FigJam23/HRV-TouchLCD-CristalAir-Invision-Serial-to-HA/HRV BUS Comms Interface/Readme.md

# Bus Comms 

<p align="center">
  <br>
  <em>This is what’s required to communicate with the HRV half-duplex TTL bus use 4k7 resistos</em>
</p>
# Comming Soon 

Instructions To build the Needed half Duplex Comms Device (Required for full Control of Fans ETC)
