FigJam23/HRV-TouchLCD-CristalAir-Invision-Serial-to-HA/ESP32/readme.md

Same As Touch Screen Binary Only change rx tx on pins 16 17 (Works with or with out a touch screen conected)




UI Screens
