FigJam23/HRV-TouchLCD-CristalAir-Invision-Serial-to-HA/Arduino Keypad Clone ESP32/Readme.md

https://youtube.com/shorts/8ISQGKKpurk?si=fGekwMP1LDX2R__V

```
static const char* AP_SSID       = "HRV-Keypad";
static const char* AP_PASS       = "12345678";  // 8+ chars required by ESP

// MQTT topics
static const char* T_FILTER_DAYS     = "hassio/hrv/filter_days_remaining/state";
static const char* T_FILTER_LIFE     = "hassio/hrv/filter_life/state";
static const char* T_FAN_PERCENT     = "hassio/hrv/fan_percent/state";
static const char* T_BOOST_ACTIVE    = "hassio/hrv/boost_active/state";
static const char* T_FILTER_NEEDED   = "hassio/hrv/filter_replacement_needed";
static const char* T_HOUSE_TEMP      = "hassio/hrv/house_temp/state";
static const char* T_HOUSE_HUM       = "hassio/hrv/house_humidity/state";
static const char* T_SETPOINT_STATE  = "hassio/hrv/setpoint/state"; // retained
static const char* T_SETPOINT_CMD    = "hassio/hrv/setpoint/set";   // retained command (optional from HA)
// Burnt Toast countdown
static const char* T_BOOST_REMAIN_S  = "hassio/hrv/boost_remaining_s/state";
static const char* T_BOOST_TOTAL_S   = "hassio/hrv/boost_total_s/state";
```
<table>
  <tr>
    <td></td>
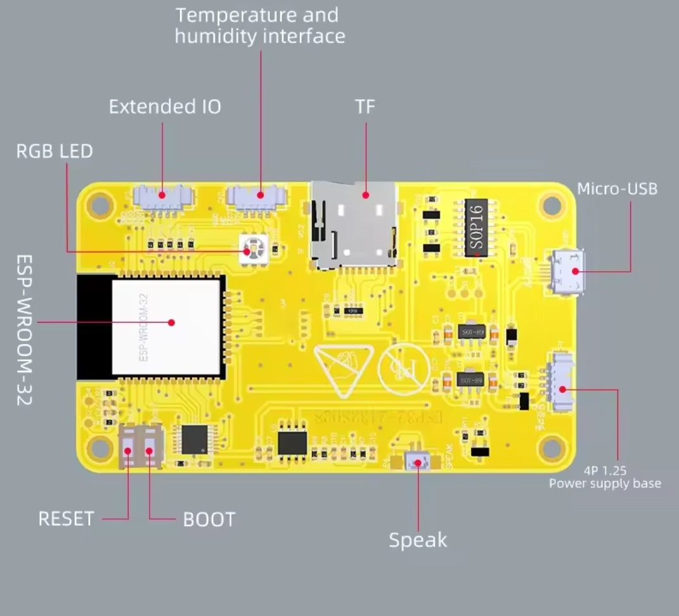
[picture p2: Arduino Keypad Clone ESP32/Screenshot_20250811_145851_AliExpress.jpg]
    <td></td>
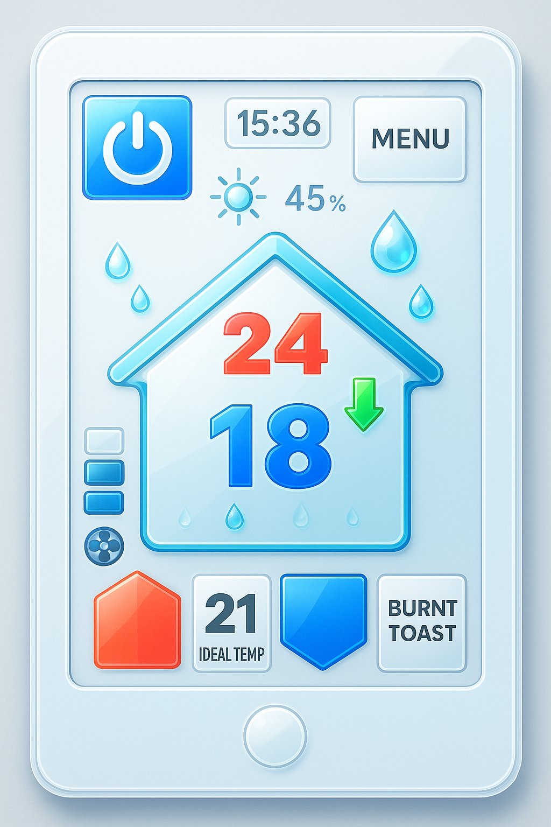
[picture p3: Arduino Keypad Clone ESP32/Keypad Home Screens/f7614291-c459-4cea-b07e-f4bfe5d946c0(4).png]
    <td></td>
  </tr>
  <tr>
    <td></td>
    <td></td>
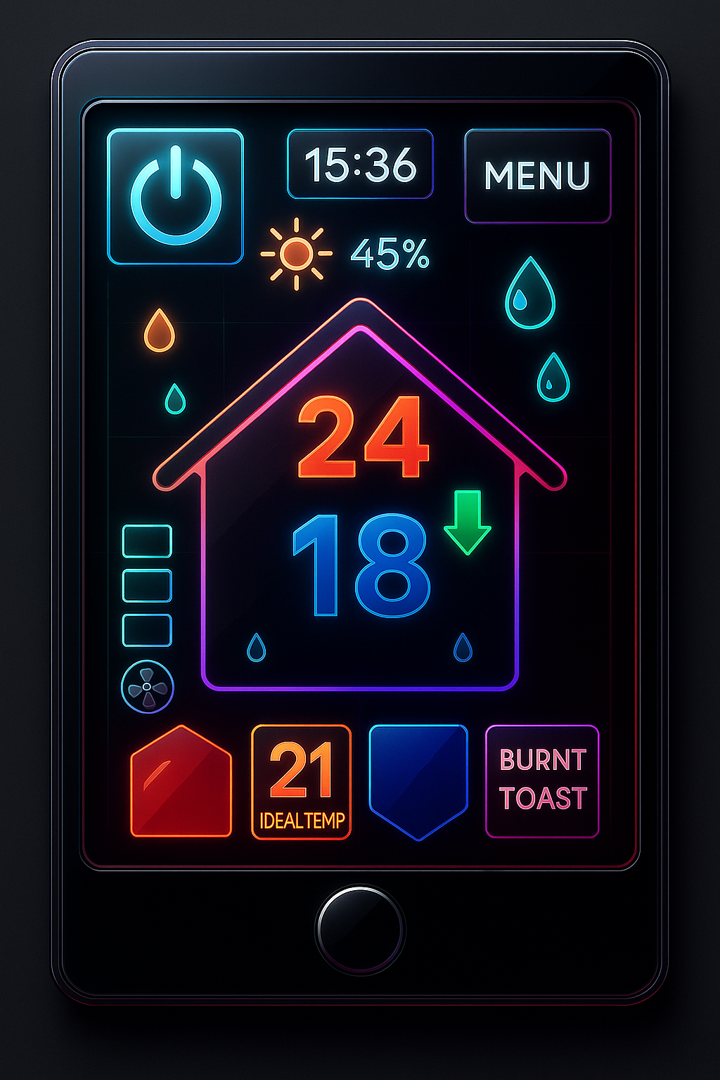
[picture p4: Arduino Keypad Clone ESP32/Keypad Home Screens/file_00000000ba5061f8b88bcc3f6a8952d6.png]
    <td></td>
  </tr>
  <tr>
    <td></td>
  </tr>
    <tr>
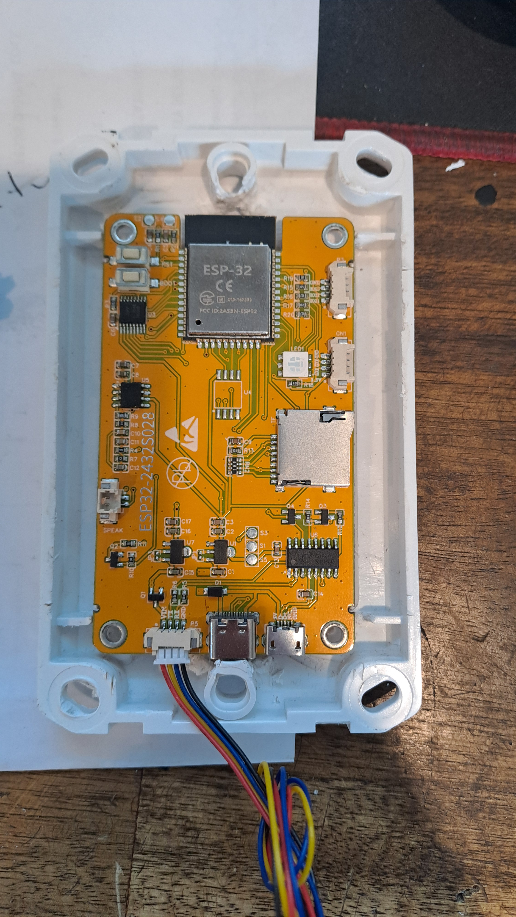
[picture p5: Arduino Keypad Clone ESP32/images/20250817_124352.jpg]
    <td></td>
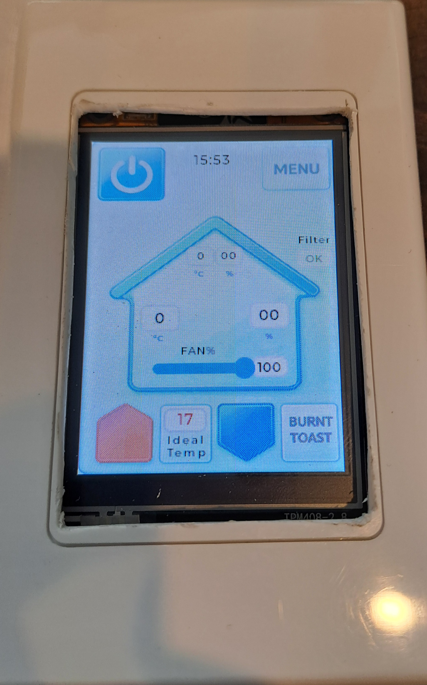
[picture p6: Arduino Keypad Clone ESP32/images/20250817_155330.jpg]
    <td></td>
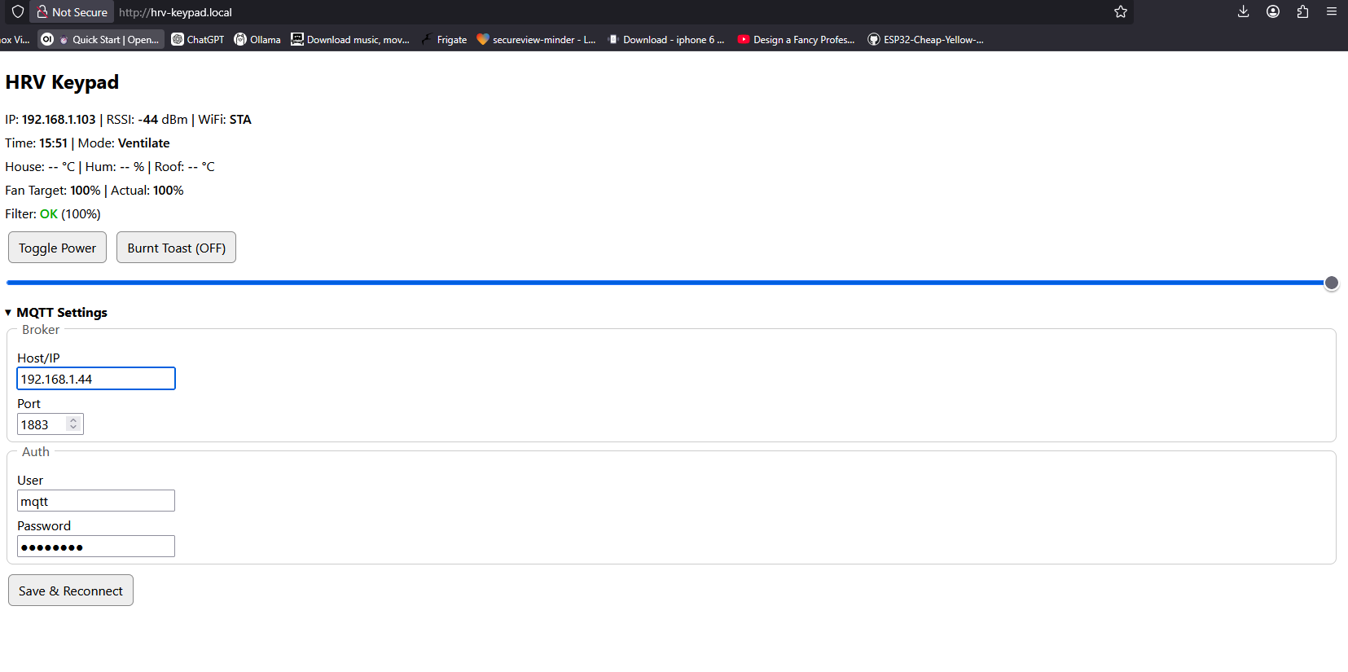
[picture p7: Arduino Keypad Clone ESP32/images/Screenshot 2025-08-17 155137.png]
    <td></td>
  </tr>
  <tr>
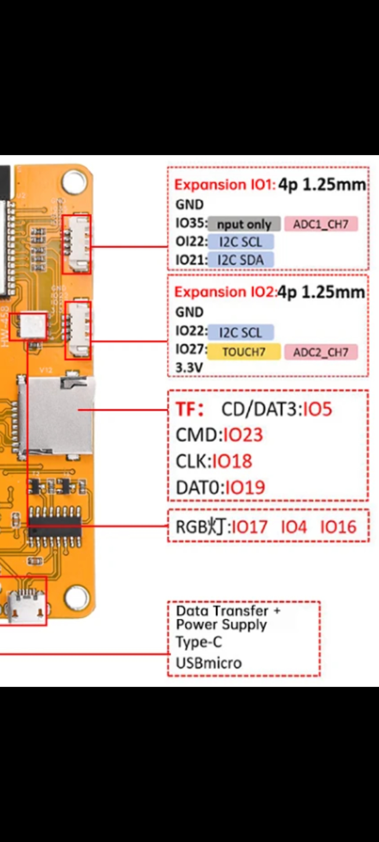
[picture p8: Arduino Keypad Clone ESP32/images/Screenshot_20250816_200522_Photos.jpg]
    <td></td>
    
    <td></td>
  </tr>

</table>
