FigJam23/HRV-TouchLCD-CristalAir-Invision-Serial-to-HA/Full Control Keypad Clone Bins/HRV ESP32 V4 Beta/Readme.md

All My main builds are based of the 2013 RV1e keypad, Seems some veriations between models etc Currently testing build for the RV2a 2015 version but not confirmed.

RV1e 2013 Confirmed Working 100pc
