FigJam23/HRV-TouchLCD-CristalAir-Invision-Serial-to-HA/Full Control Keypad Clone Bins/HRV ESP32 V4 Beta/HRV Keypad RV2a 2015/Readme.md

RV2a 2015 In testing

RV2a 2015
