FigJam23/HRV-TouchLCD-CristalAir-Invision-Serial-to-HA/Full Control Keypad Clone Bins/HRV ESP32 V4 Beta/4.6/Readme.md

Fixed Wifi Drop Issue, Hot cold temp icons poll on of when heating cooloing
