FigJam23/HRV-TouchLCD-CristalAir-Invision-Serial-to-HA/Full Control Keypad Clone Bins/HRV ESP32 V4 Beta/V42/Readme.md

Fixed Touch sounds on board speaker now working... Beep Beep
