FigJam23/HRV-TouchLCD-CristalAir-Invision-Serial-to-HA/Full Control Keypad Clone Bins/HRV ESP32 V3/ESP32 Only No Touch/Readme.md

```
/***********************
 *  HRV UART  (half-duplex bus)
 ***********************/
#define HRV_RX_PIN 16
#define HRV_TX_PIN 17

/***********************
 *  SHT31 on I²C
 ***********************/
static const int PIN_I2C_SDA = 27;
static const int PIN_I2C_SCL = 22;
```
