FigJam23/HRV-TouchLCD-CristalAir-Invision-Serial-to-HA/Full Control Keypad Clone Bins/HRV ESP32 V4 Beta/V4.1/Readme.md

added burnt toast timeer on ui above button touch screen and layout adjustments
