FigJam23/HRV-TouchLCD-CristalAir-Invision-Serial-to-HA/20250714_192907.jpg

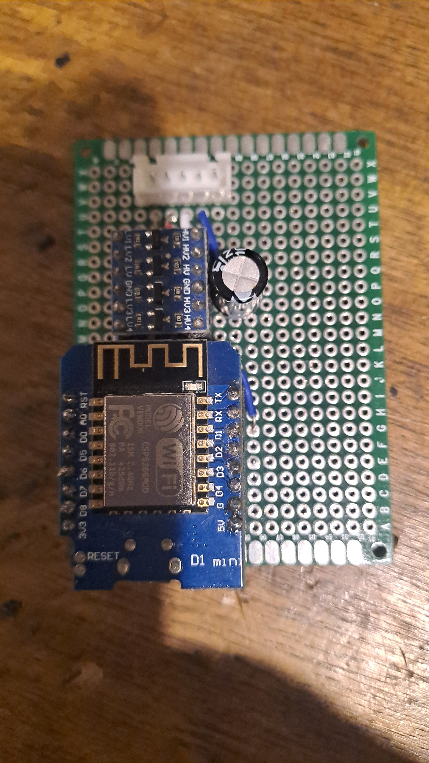
20250714_192907.jpg
