FigJam23/HRV-TouchLCD-CristalAir-Invision-Serial-to-HA/20250818_155539.jpg

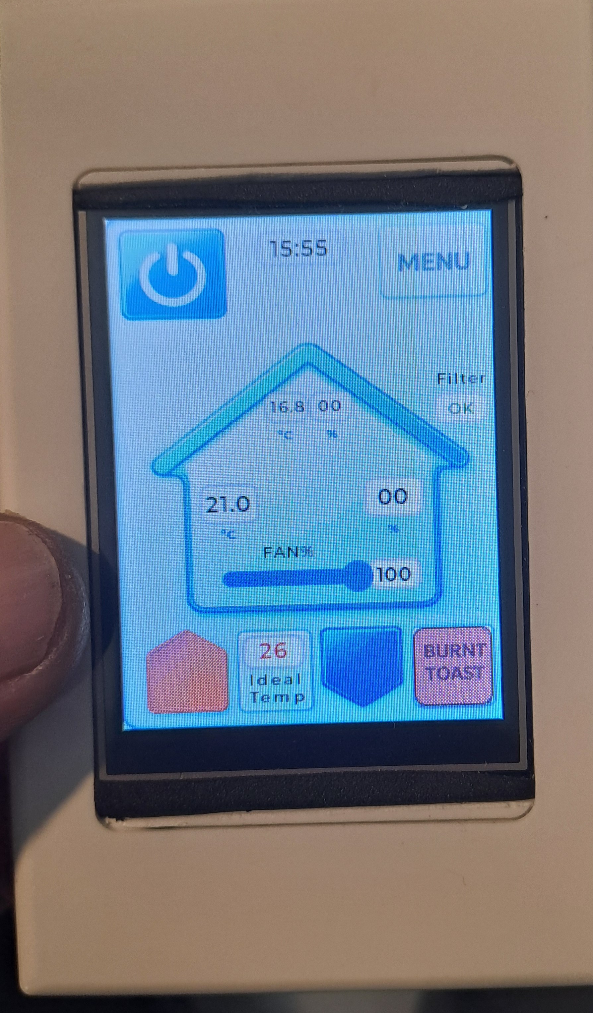
20250818_155539.jpg
