FigJam23/HRV-TouchLCD-CristalAir-Invision-Serial-to-HA/Arduino Keypad Clone ESP32/images/bbd767784d31bf599c95695f3c9962272ce6594b.png

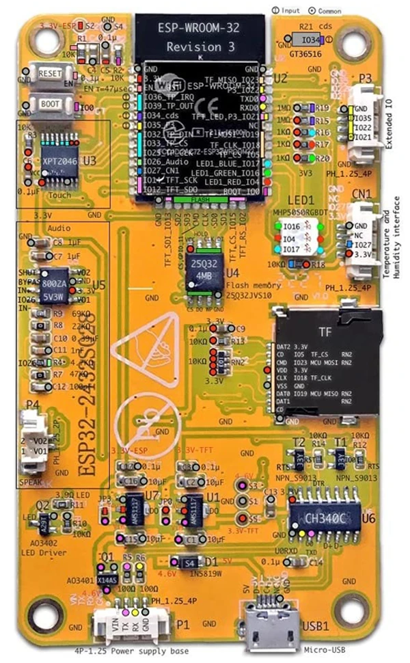
Arduino Keypad Clone ESP32/images/bbd767784d31bf599c95695f3c9962272ce6594b.png
