FigJam23/HRV-TouchLCD-CristalAir-Invision-Serial-to-HA/deepseek_mermaid_20250728_1d9936.jpg

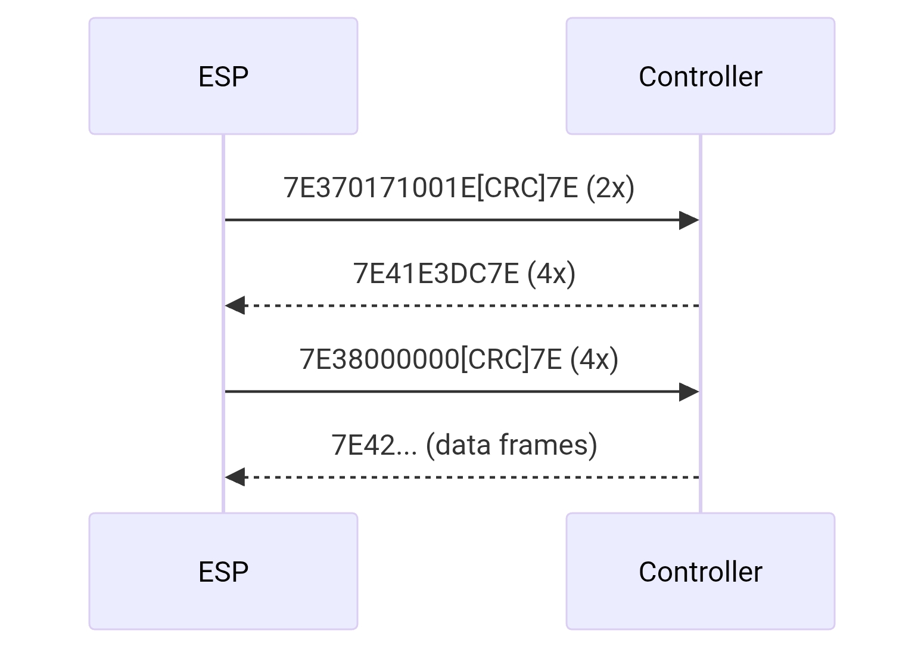
deepseek_mermaid_20250728_1d9936.jpg
