FigJam23/HRV-TouchLCD-CristalAir-Invision-Serial-to-HA/EspHome/ESPhome Sniffing/working on/image.png

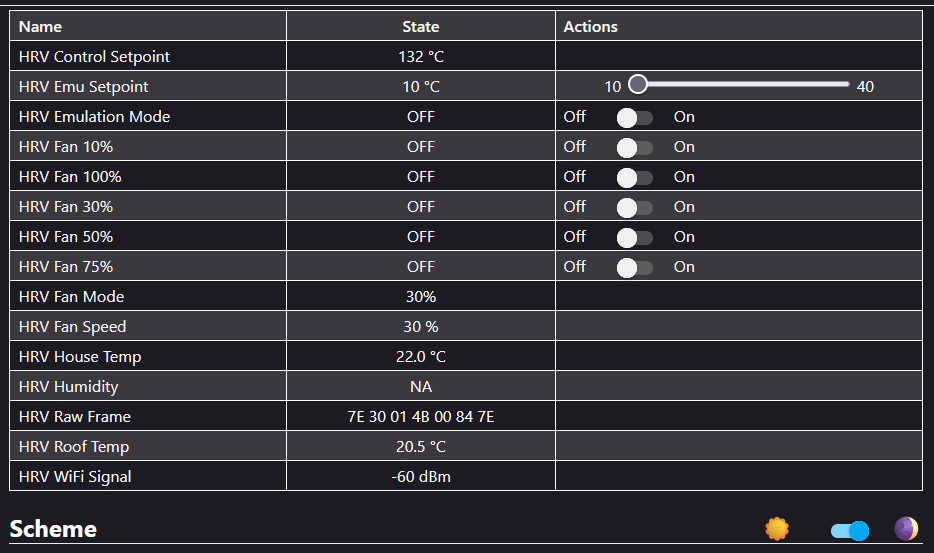
EspHome/ESPhome Sniffing/working on/image.png
