FigJam23/HRV-TouchLCD-CristalAir-Invision-Serial-to-HA/image.png

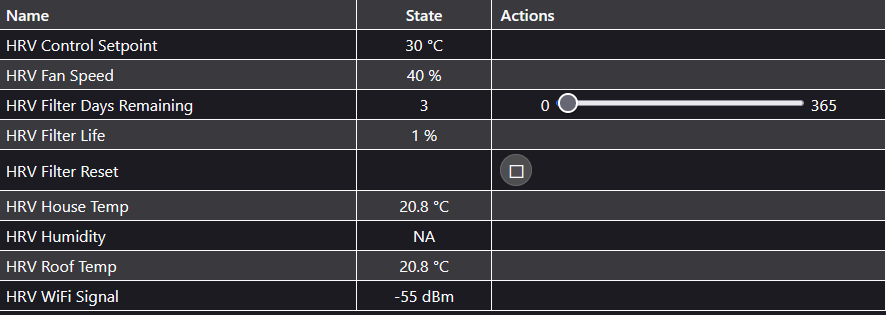
image.png
