FigJam23/HRV-TouchLCD-CristalAir-Invision-Serial-to-HA/Images/3.jpg

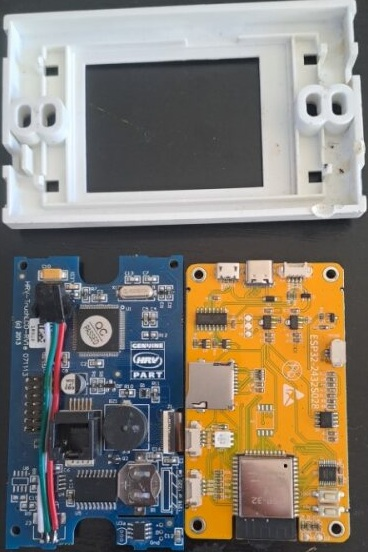
Images/3.jpg
