FigJam23/HRV-TouchLCD-CristalAir-Invision-Serial-to-HA/Images/4.jpg

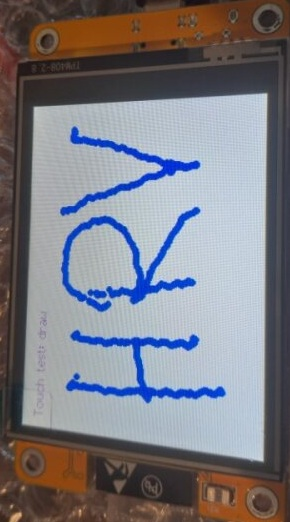
Images/4.jpg
