FigJam23/HRV-TouchLCD-CristalAir-Invision-Serial-to-HA/Images/5.jpg

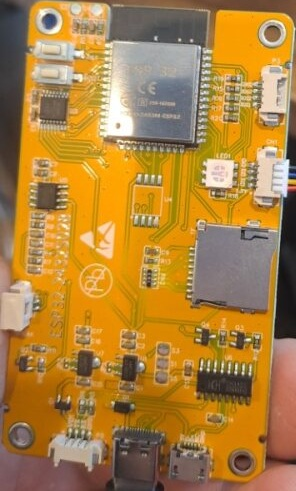
Images/5.jpg
