FigJam23/HRV-TouchLCD-CristalAir-Invision-Serial-to-HA/Images/airsense-control-panel-and-app.jpg.webp

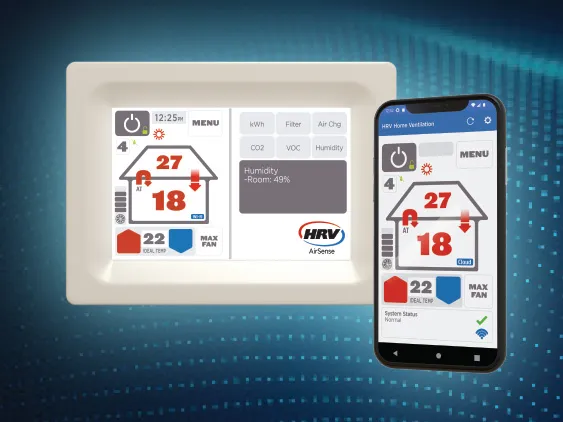
Images/airsense-control-panel-and-app.jpg.webp
