FigJam23/HRV-TouchLCD-CristalAir-Invision-Serial-to-HA/Images/Screenshot_20250714_153120_Photos.jpg

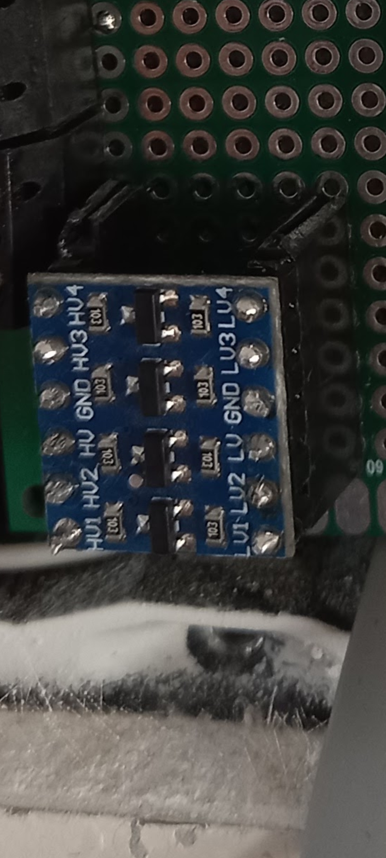
Images/Screenshot_20250714_153120_Photos.jpg
