FigJam23/HRV-TouchLCD-CristalAir-Invision-Serial-to-HA/Images/Screenshot_20250822_185936_Home Assistant.jpg

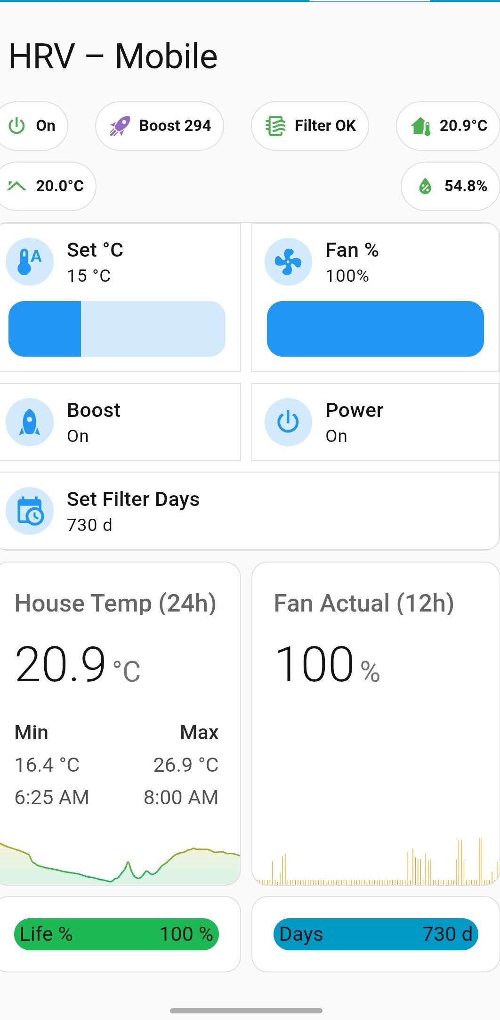
Images/Screenshot_20250822_185936_Home Assistant.jpg
