FigJam23/HRV-TouchLCD-CristalAir-Invision-Serial-to-HA/Images/Screenshot_20250822_191944_Chrome.jpg

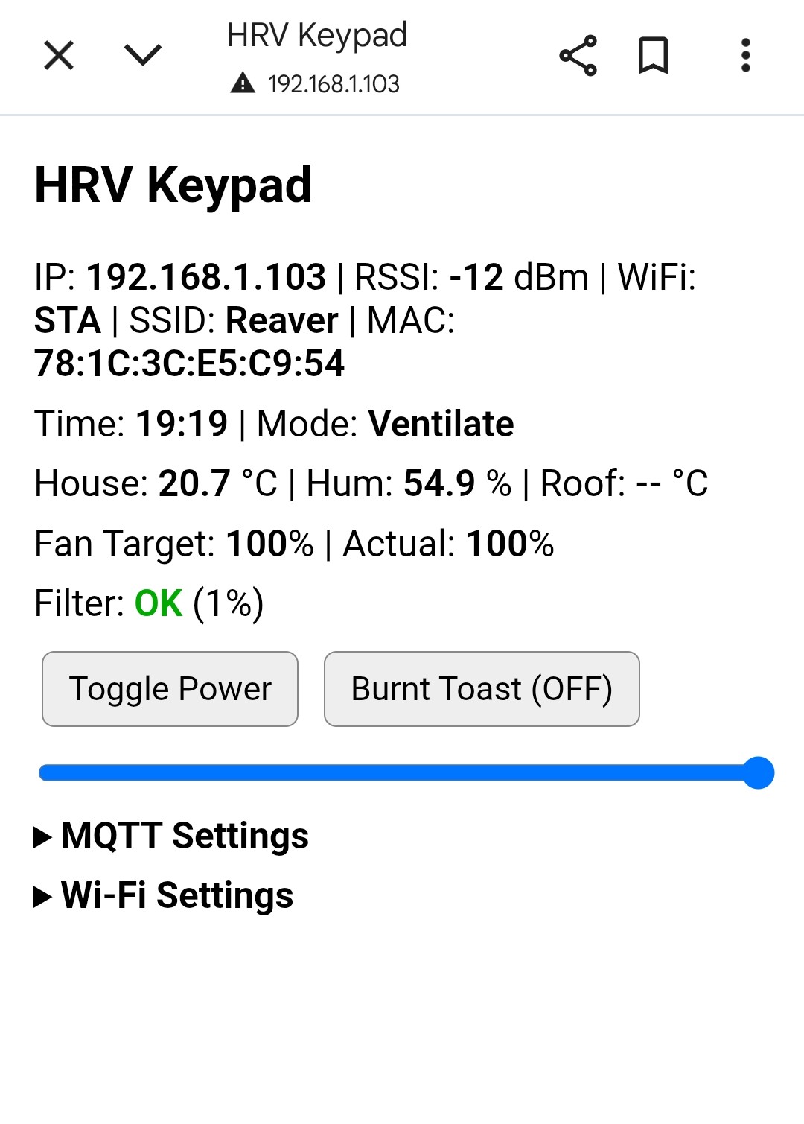
Images/Screenshot_20250822_191944_Chrome.jpg
