FigJam23/HRV-TouchLCD-CristalAir-Invision-Serial-to-HA/Images/Sniffing Disconected Keypad/20250720_173254.jpg

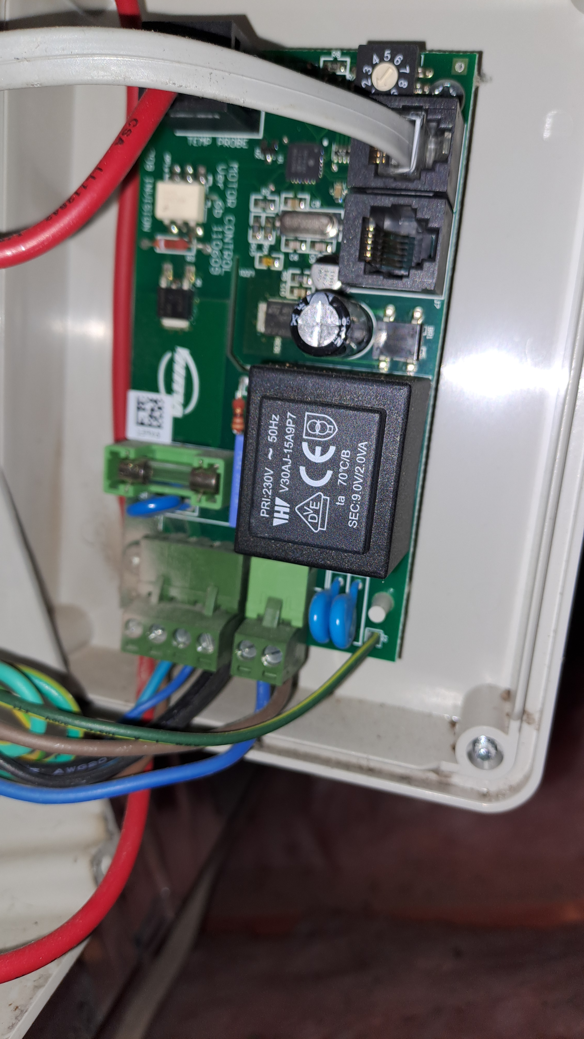
Images/Sniffing Disconected Keypad/20250720_173254.jpg
