FigJam23/HRV-TouchLCD-CristalAir-Invision-Serial-to-HA/Images/Sniffing Disconected Keypad/20250724_174808~2.jpg

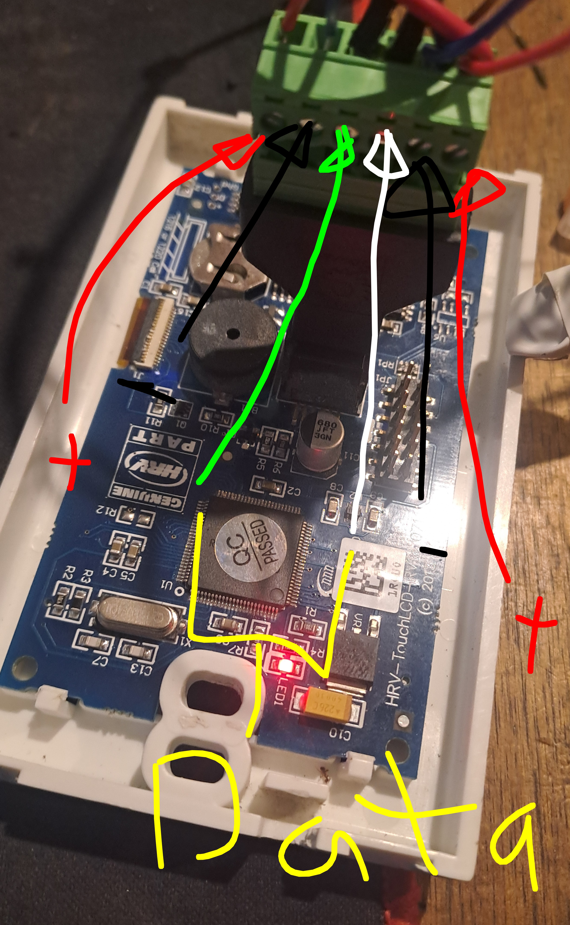
Images/Sniffing Disconected Keypad/20250724_174808~2.jpg
