FigJam23/HRV-TouchLCD-CristalAir-Invision-Serial-to-HA/Screenshot_20250712_155710_Home Assistant.jpg

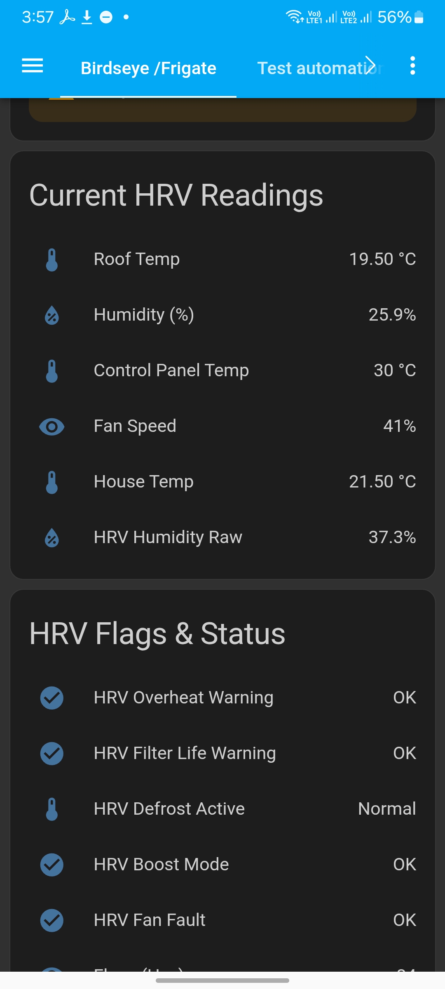
Screenshot_20250712_155710_Home Assistant.jpg
