FigJam23/HRV-TouchLCD-CristalAir-Invision-Serial-to-HA/Screenshot_20250721_180635_Photos~3.jpg

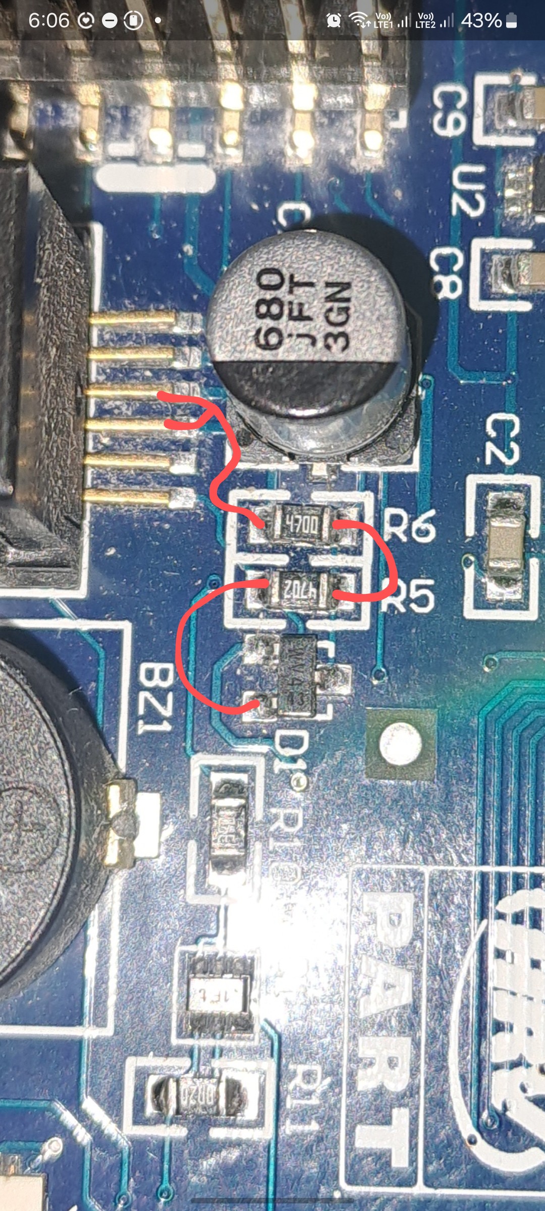
Screenshot_20250721_180635_Photos~3.jpg
