FigJam23/HRV-TouchLCD-CristalAir-Invision-Serial-to-HA/Screenshot_20250722_090203_Google.jpg

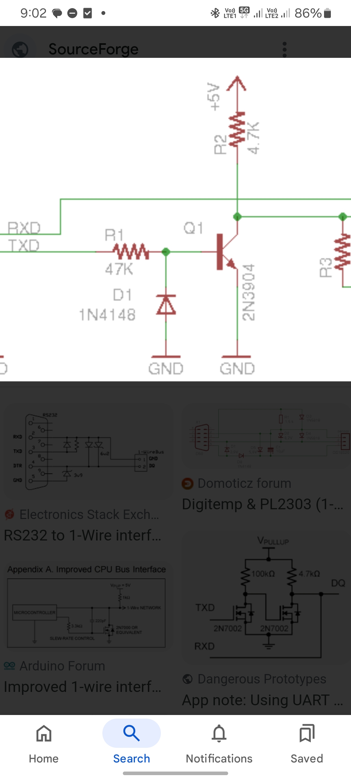
Screenshot_20250722_090203_Google.jpg
