FigJam23/HRV-TouchLCD-CristalAir-Invision-Serial-to-HA/Screenshot_20250722_173159_AliExpress.jpg

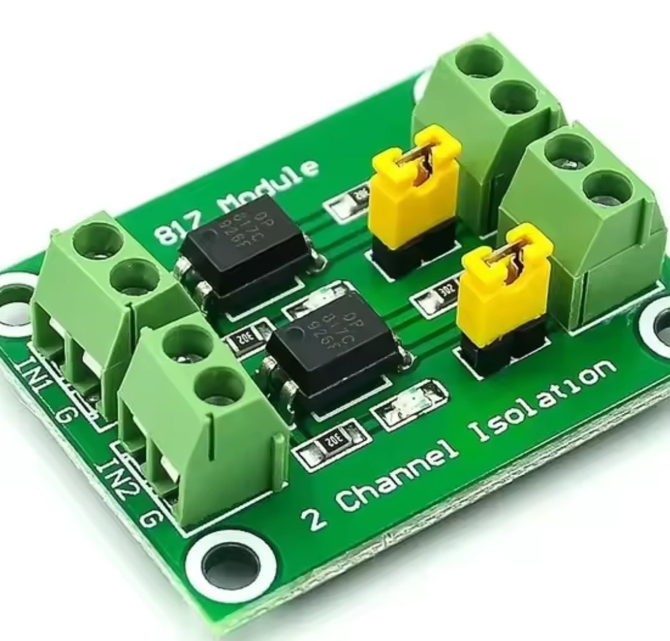
Screenshot_20250722_173159_AliExpress.jpg
