FigJam23/HRV-TouchLCD-CristalAir-Invision-Serial-to-HA/Sniffing Disconected Keypad/20250724_193508~2.jpg

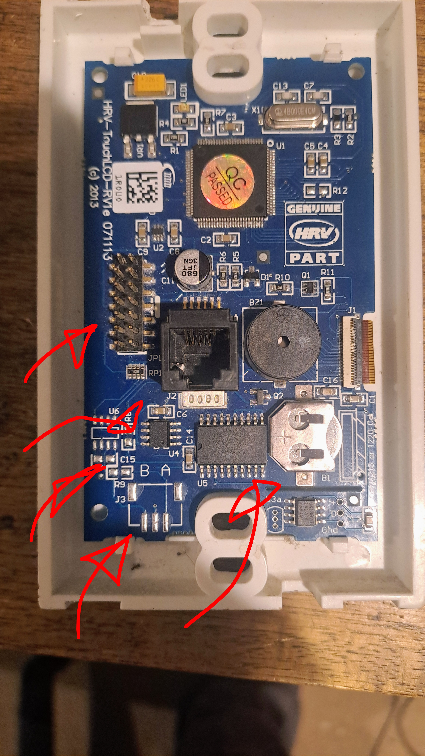
Sniffing Disconected Keypad/20250724_193508~2.jpg
