FigJam23/HRV-TouchLCD-CristalAir-Invision-Serial-to-HA/Sniffing Disconected Keypad/Screenshot_20250720_165147_Photos.jpg

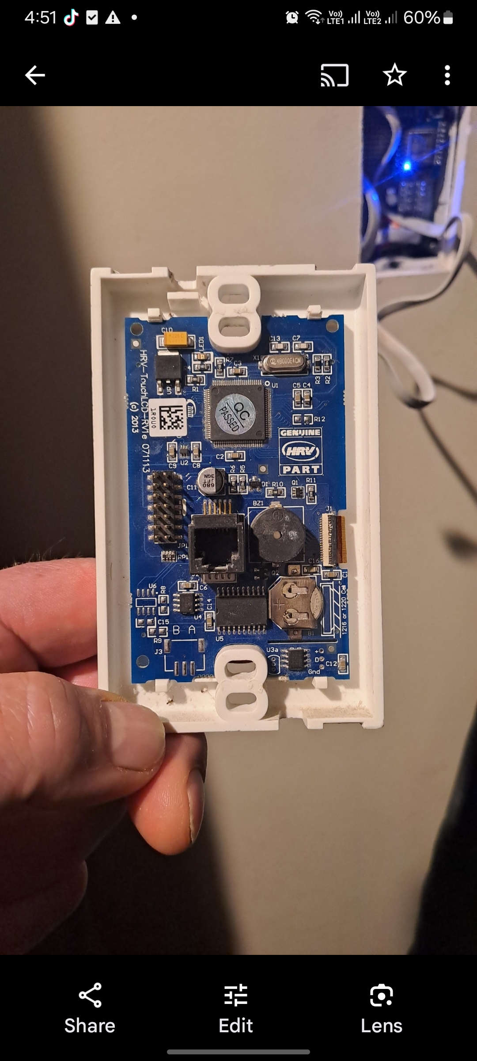
Sniffing Disconected Keypad/Screenshot_20250720_165147_Photos.jpg
