FigJam23/HRV-TouchLCD-CristalAir-Invision-Serial-to-HA/Sniffing Disconected Keypad/Screenshot_20250724_211950_AliExpress.jpg

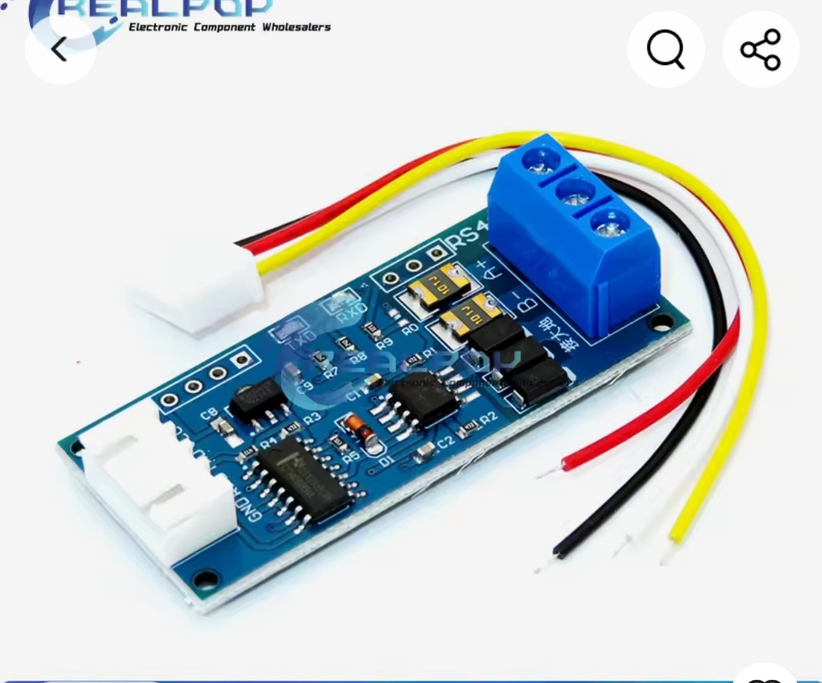
Sniffing Disconected Keypad/Screenshot_20250724_211950_AliExpress.jpg
