FigJam23/HRV-TouchLCD-CristalAir-Invision-Serial-to-HA/Prototype Keypad Building/readme.md

## Prototype Keypad Build Photos

<p align="center">
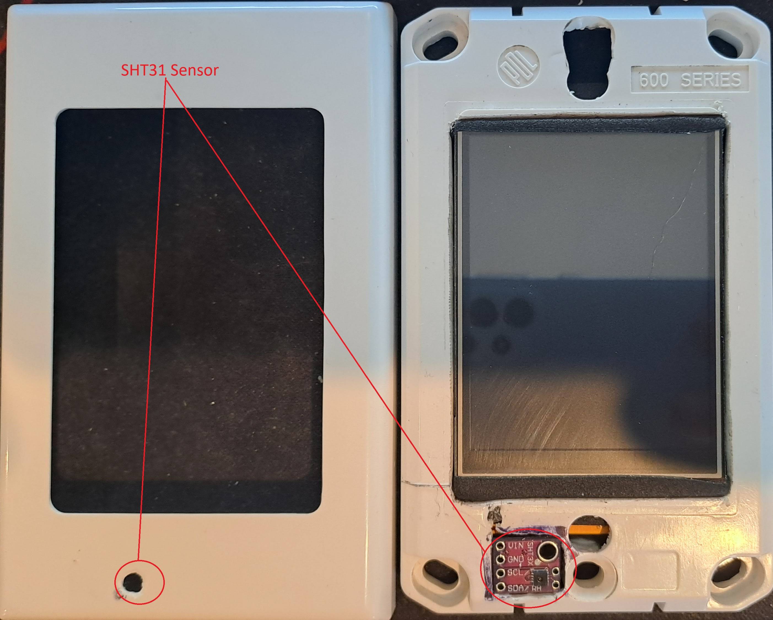
[picture p39: Prototype Keypad Building/Images/Front.jpg]
  
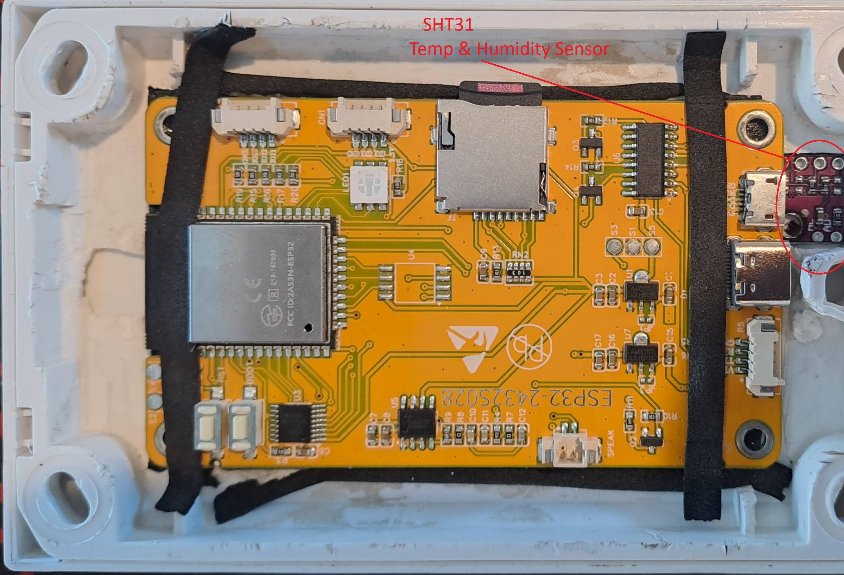
[picture p40: Prototype Keypad Building/Images/Back.jpg]
  
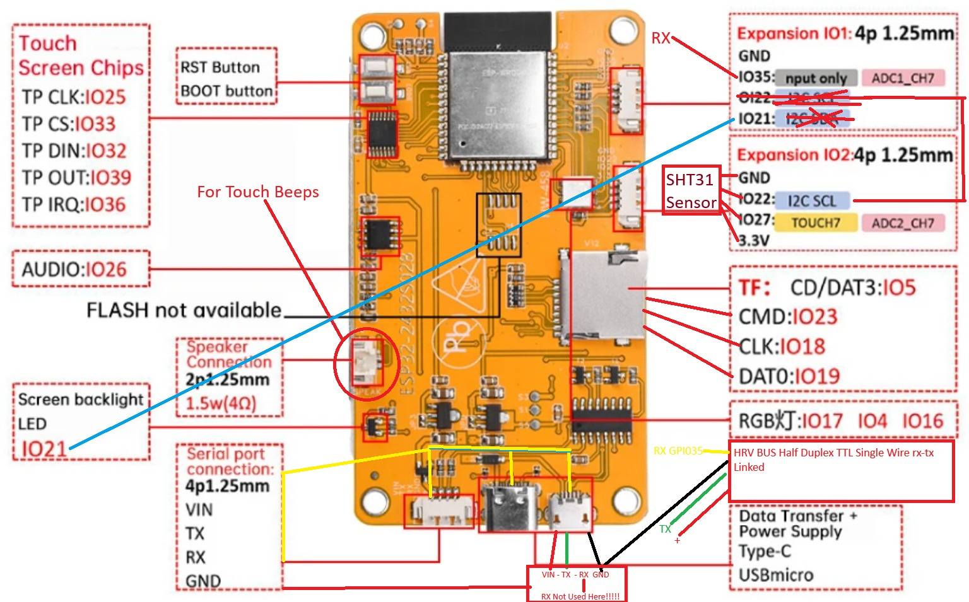
[picture p41: Prototype Keypad Building/Images/GPIOs.jpg]
  
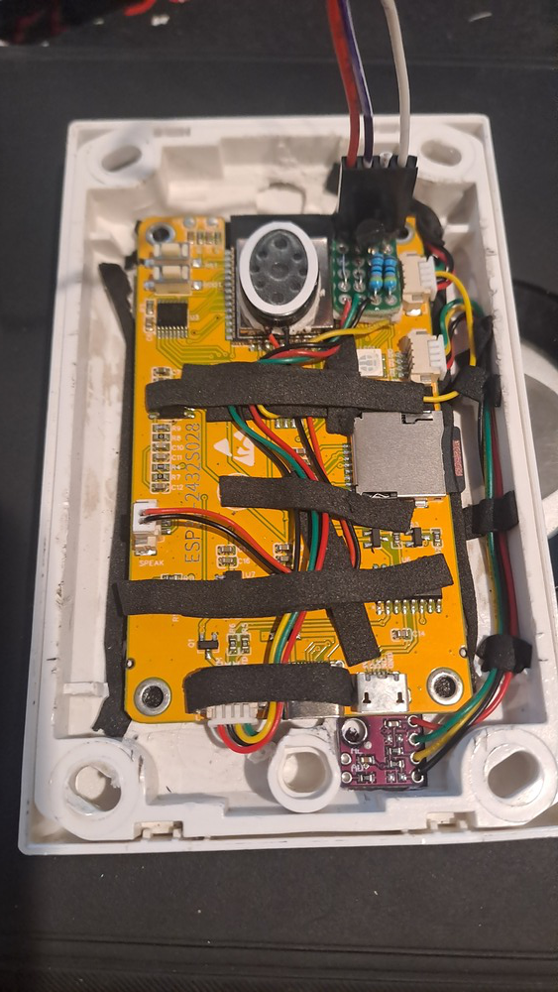
[picture p42: Prototype Keypad Building/Images/1000014449.jpg]
  
  
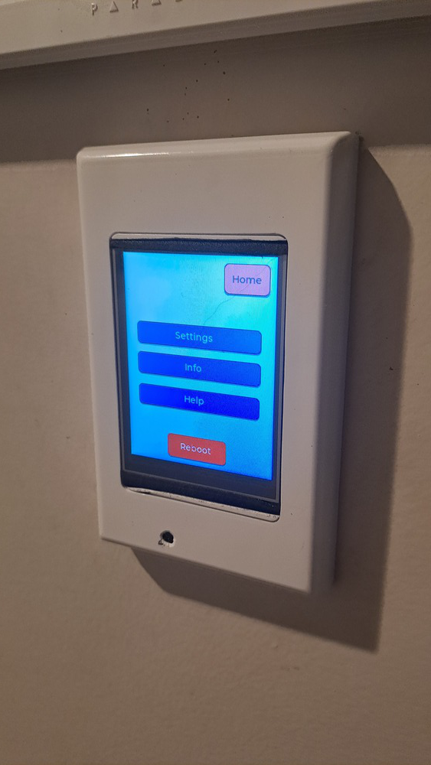
[picture p43: Prototype Keypad Building/Images/1000014453.jpg]
  
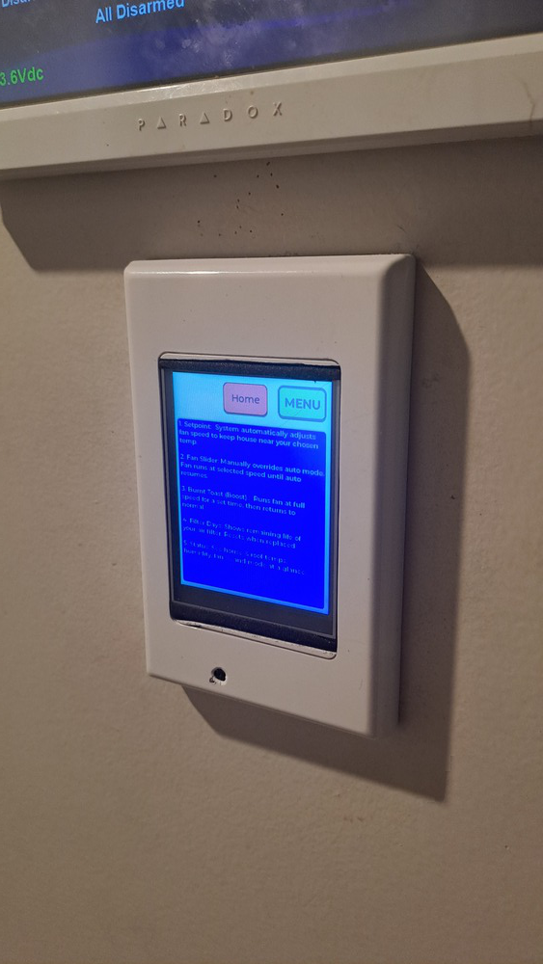
[picture p44: Prototype Keypad Building/Images/1000014454.jpg]
  
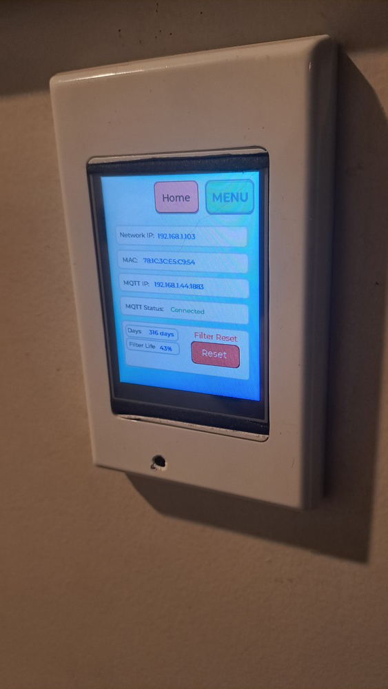
[picture p45: Prototype Keypad Building/Images/1000014455.jpg]
  
</p>
