FigJam23/HRV-TouchLCD-CristalAir-Invision-Serial-to-HA/New Keypad Build ESP32/Readme.md

<table>
  <tr>
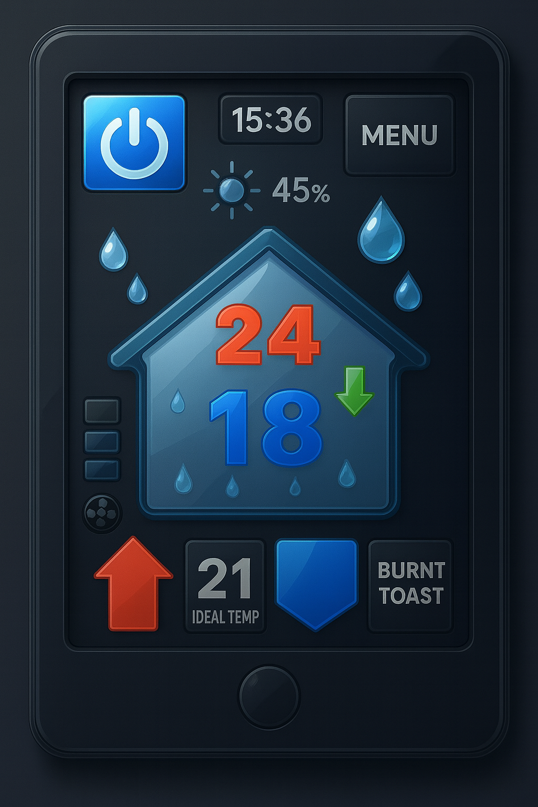
[picture p46: New Keypad Build ESP32/Keypad Home Screens/6e0b0809-e17d-45b1-8727-2efd2609b403.png]
    <td></td>
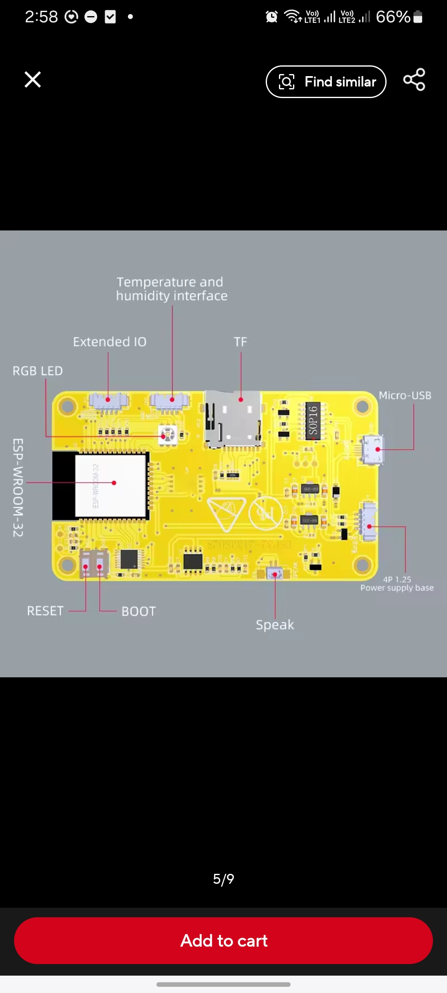
[picture p47: New Keypad Build ESP32/Screenshot_20250811_145851_AliExpress.jpg]
    <td></td>
    <td></td>
  </tr>
  <tr>
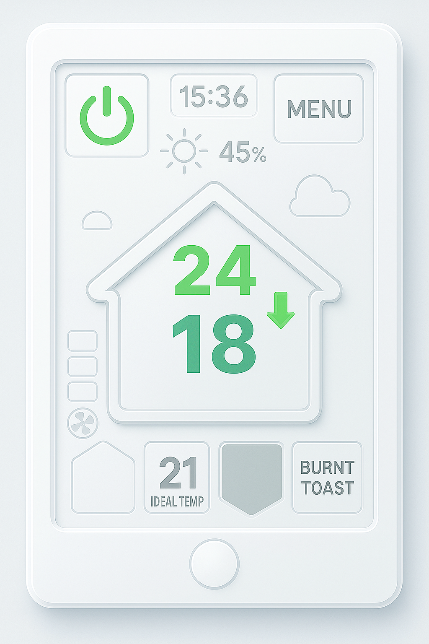
[picture p48: New Keypad Build ESP32/file_0000000060ec61fd84d62c2a60668eef.png]
    <td></td>
    <td></td>
    <td></td>
  </tr>
  <tr>
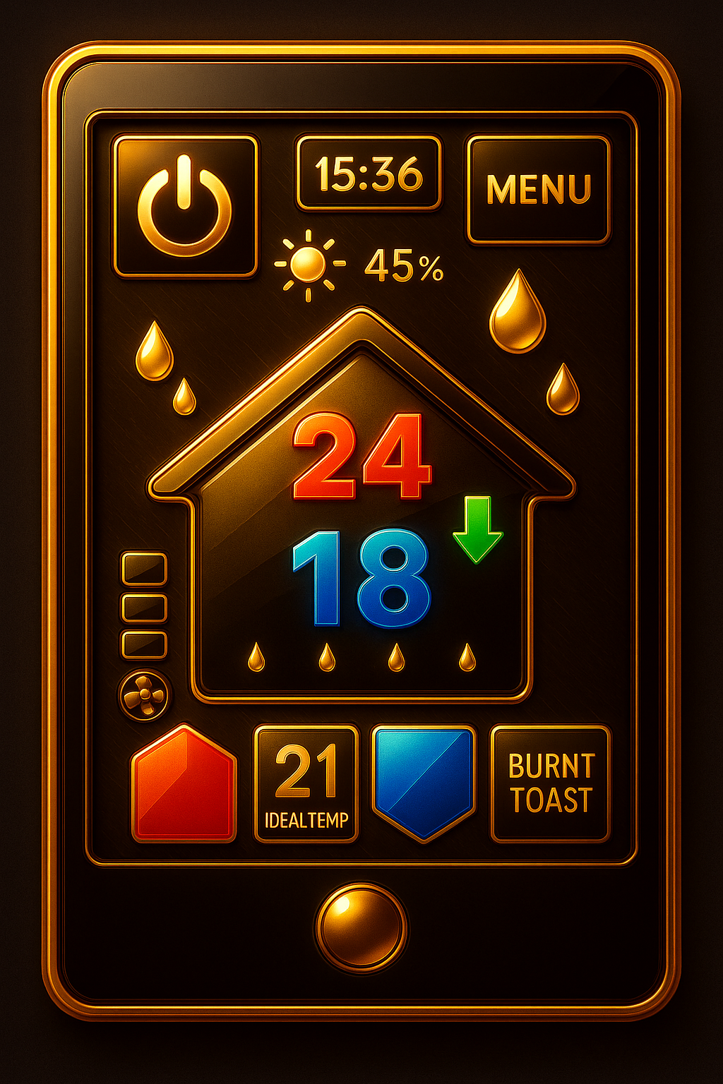
[picture p49: New Keypad Build ESP32/file_00000000bd6c622f9eaf868b7891e35b.png]
    <td></td>
  </tr>
</table>
