FigJam23/HRV-TouchLCD-CristalAir-Invision-Serial-to-HA/New Keypad Build ESP32/Buttons/Buttons/A.ied Buttons fixed/8f88e674-2bb5-4460-9fbf-68aa3fef49e2.png

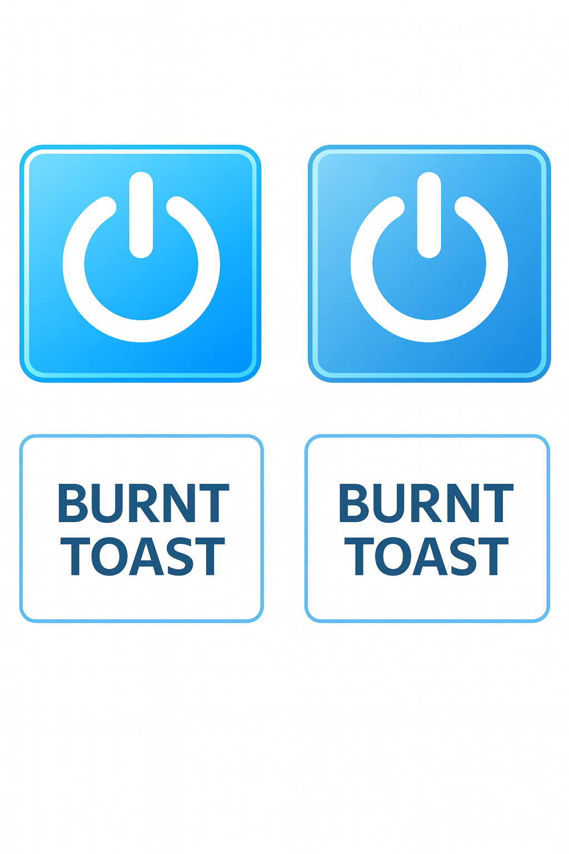
New Keypad Build ESP32/Buttons/Buttons/A.ied Buttons fixed/8f88e674-2bb5-4460-9fbf-68aa3fef49e2.png
