FigJam23/HRV-TouchLCD-CristalAir-Invision-Serial-to-HA/New Keypad Build ESP32/Buttons/Buttons/A.ied Buttons fixed/ChatGPT Image Aug 12, 2025, 06_02_07 PM.png

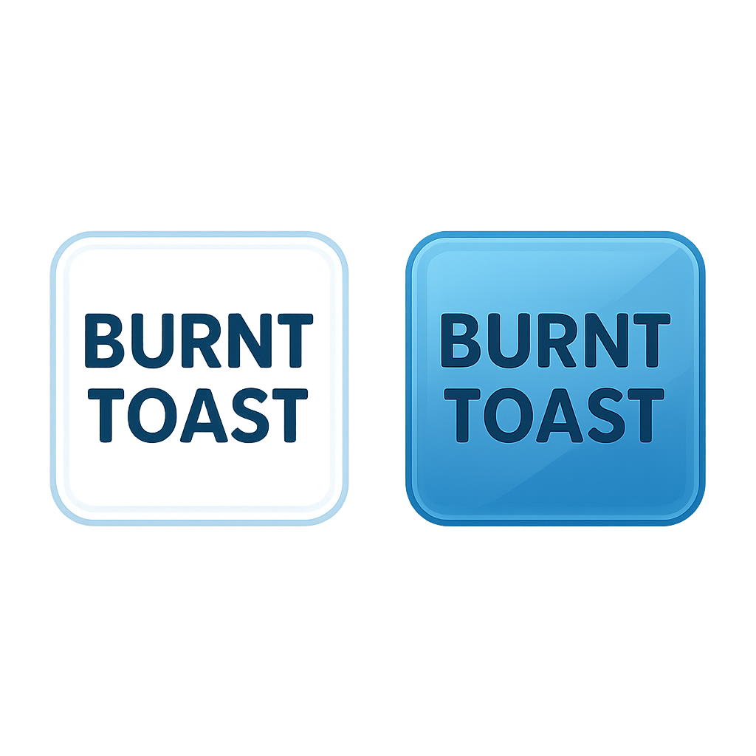
New Keypad Build ESP32/Buttons/Buttons/A.ied Buttons fixed/ChatGPT Image Aug 12, 2025, 06_02_07 PM.png
