FigJam23/HRV-TouchLCD-CristalAir-Invision-Serial-to-HA/New Keypad Build ESP32/Buttons/Power OnOff.png

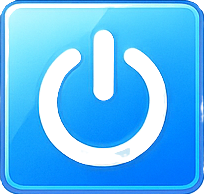
New Keypad Build ESP32/Buttons/Power OnOff.png
