FigJam23/HRV-TouchLCD-CristalAir-Invision-Serial-to-HA/New Keypad Build ESP32/file_0000000086a461f8abbdfd0f251aac8b.png

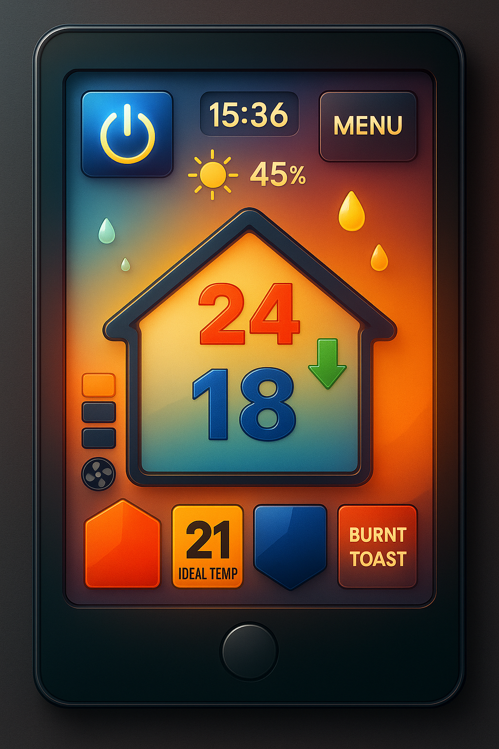
New Keypad Build ESP32/file_0000000086a461f8abbdfd0f251aac8b.png
