FigJam23/HRV-TouchLCD-CristalAir-Invision-Serial-to-HA/New Keypad Build ESP32/Touch Screen Building Project/Images/2.jpg

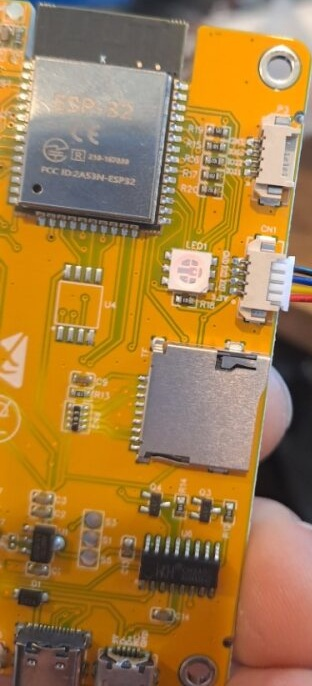
New Keypad Build ESP32/Touch Screen Building Project/Images/2.jpg
