FigJam23/HRV-TouchLCD-CristalAir-Invision-Serial-to-HA/Full Control Keypad Clone Bins/Working On V3 Testing with Temp MQTT Overides for Temps and Humdity/readme.md

My Custom Temp Humidity Sensors Used for testing..
house/temperature
house/humidity
roof/temperature
roof/humidity
