FigJam23/HRV-TouchLCD-CristalAir-Invision-Serial-to-HA/(commit log)

2025-07-10 Update HRV_TO_MQTT_Auth_NO_OTA.ino
    added debug sensor to grab control cmds for testing hrv control over serial cmds
2025-07-10 Create Fixed Fan reading to hassio and mqtt user password pluse reading and sending hex data back to keypad
2025-07-10 Update Fixed Fan reading to hassio and mqtt user password pluse reading and sending hex data back to keypad
2025-07-12 Rename Fixed Fan reading to hassio and mqtt user password pluse reading and sending hex data back to keypad to Arduino Fixed Fan reading to hassio and mqtt user password pluse reading and sending hex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
2025-07-12 Create HRV MQTT More sensors added
2025-07-12 Added additiona sensors
2025-07-12 Rename Test sending two data blocks to ESP{ Home Test sending two data blocks Burnt toast and max fan frames
2025-07-12 Create Control HRV TESPhome added sending single frames
2025-07-14 Create Arduino Ide version Sending cmands from hassio
2025-07-14 Create Arduino Keypad Emulation test
2025-07-20 Create Normal sensor data and emulation mode fan Control etc
2025-07-20 Update Normal sensor data and emulation mode fan Control etc
2025-07-22 Add files via upload
    Why This Device is Needed for TX (Transmitting Data)
    Most HRV controllers communicate using a shared single-wire, 5V half-duplex serial bus (like open collector or open-drain logic). This means:
    Devices pull the line LOW to transmit, and release it to HIGH (via pull-up) when idle.
    The bus expects open-collector/open-drain signaling, not direct voltage swings like 3.3V or 5V TX from ESP devices.
    🔌 Problem:
    A normal ESP8266/ESP32 TX pin (like D1) outputs a push-pull 3.3V signal, which does not behave like an open collector.
    This risks collisions, no acknowledgment, or even damage when the HRV controller tries to pull the line LOW at the same time.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
2025-07-22 Update README.md
    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
2025-07-24 Add files via upload
    # Part Notes
    1 RJ-11 “Bus” Port (JP1) The 6-pin jack where the panel plugs in. Pins 1/6 = 12 V supply, 2/5 = GND, <br>3 = TTL-RX, 4 = TTL-TX.
    2 TTL Header Small 5-pin header just above the RJ-11. Labeled TXD, RXD, VCC, GND, EN (enable).
    3 RS-485 Transceiver (U5) Bottom-center 16-pin chip next to the “B A” silk-screen. Likely a MAX3485 or MAX13487.
    4 RS-485 Bus Pads (B/A) The two solder-pad pairs marked “B” and “A” just below U4/U5. These go out to the roof unit.
    5 TTL-to-5 V Regulator + Shifter (U4) Small 6-pin IC just above the B/A pads. Handles level-shifting for the TTL header.
    6 Main MCU (U1) The big square at top-center—runs the touch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
2025-07-27 Create sniffing logs for filter life value changes
2025-07-27 Create ESPhome filter life testing trial 1
2025-07-27 Update ESPhome filter life testing trial 1
2025-07-28 Update Esphome Recomended Version
    Added filter Life
2025-07-28 Update recomended version
    Added Filter Life
2025-07-28 Filter Life Added
2025-07-29 Update Esphome Dual Controllers
    Updated Filter life to two years as Per HRV Docs
2025-07-29 Update Esphome Recomended Version
    Updated Filter Life to Two Years as per HRV Docs
2025-07-29 Update Esphome Dual Controllers
    Filter data restored via mqtt broker on power resets
2025-07-29 Update Esphome Recomended Version
    Filter Data restored by MQTT Broker
2025-08-08 Create burnt toats mode part working first sucsessfull fan controll
2025-08-08 Create burnt toast fan control v2
2025-08-08 Create full fan speed controll
2025-08-08 Create FULL FAN CONTROL 0 TO 100 PERCENT SLIDER
2025-08-08 Create full fan control slider 0 to 100 percent speed control
2025-08-08 Update FULL FAN CONTROL 0 TO 100 PERCENT SLIDER
2025-08-09 Create Esphome First working version with fan controlls testing
2025-08-09 Rename Esphome First working version with fan controlls testing to Esphome First working version with Working fan controlls testing
2025-08-09 Create latest trying to get actual fan speed from controller
2025-08-09 Update Esphome First working version with Working fan controlls testing
2025-08-10 Rename Esphome First working version with Working fan controlls testing to Esphome Full Controll Keypdad Replacment
    DHT Sensors added
2025-08-10 Create Keypad Replacment fan Controll
2025-08-10 Update Keypad Replacment fan Controll
2025-08-10 Create Current Controll 11.8.25
2025-08-10 Update Current Controll 11.8.25
2025-08-10 Rename Current Controll 11.8.25 to Esphome Current Controll 11.8.25
2025-08-10 Create mqtt sensors names
2025-08-11 Create Esphome More Features But running Out Of Memory had to disable web server
    Web server Disabled, Will be moving to a ESP32
2025-08-11 Rename Esphome First Version to Esphome ESP32 First Version
2025-08-11 Update Esphome ESP32 First Version
2025-08-11 Update Esphome Current Controll 11.8.25
2025-08-19 Create readme.md
    Adding Latest Touch Screen Working Bin File with full control of fan controllers
2025-08-23 Create Full control Esp32 with or without Screen v2 OTA
2026-05-07 Add touchscreen frame data to Touchscreen cap.txt
    Added multiple frame data entries for touchscreen communication.
2026-05-08 Update Readme with HRV profile example
    Added example JSON configuration for HRV learned profile with detailed fan mode settings and statistics.
