FigJam23/HRV-TouchLCD-CristalAir-Invision-Serial-to-HA/Images/20250810_134654.jpg

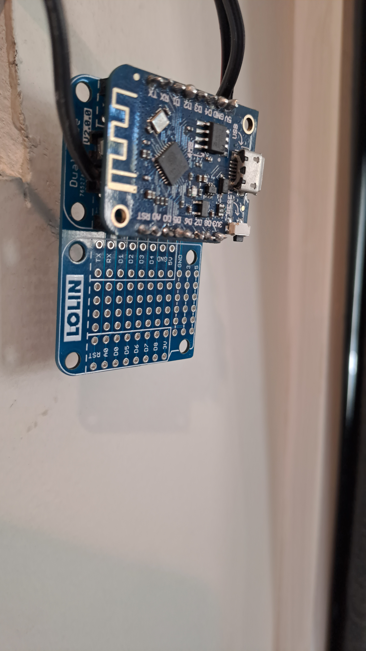
Images/20250810_134654.jpg
