FigJam23/HRV-TouchLCD-CristalAir-Invision-Serial-to-HA/Images/Sniffing Disconected Keypad/20250724_174816.jpg

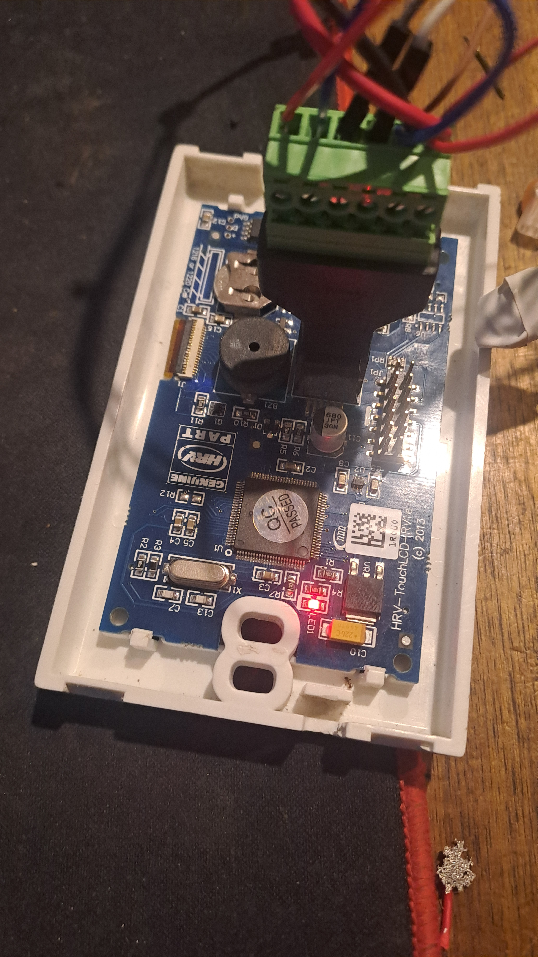
Images/Sniffing Disconected Keypad/20250724_174816.jpg
