FigJam23/HRV-TouchLCD-CristalAir-Invision-Serial-to-HA/Images/Sniffing Disconected Keypad/20250727_185903.jpg

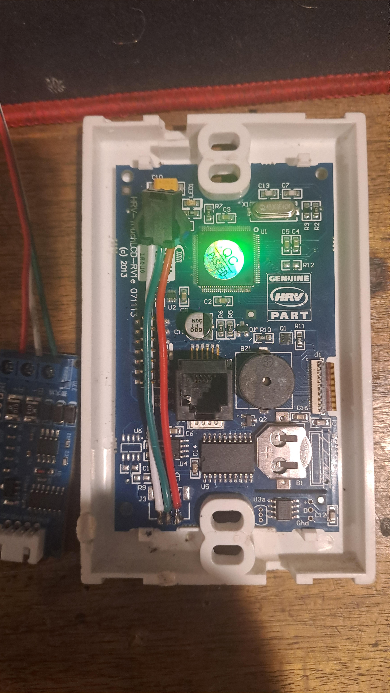
Images/Sniffing Disconected Keypad/20250727_185903.jpg
